f18c052f/self-automated_hikikomori/3D Printer/PrusaSlicer/Lid_of_servo_mini.3mf

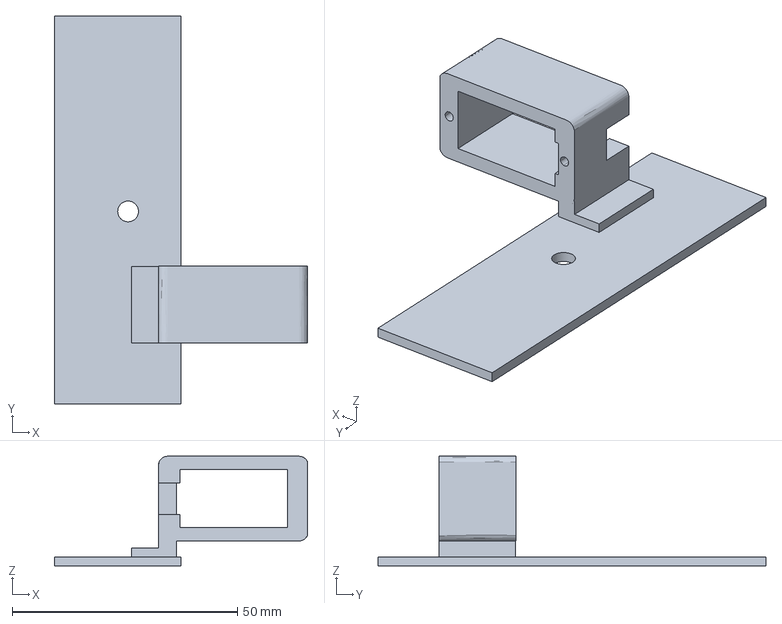
[picture p10: CAD file, 2025-05-03]
3D Printer/PrusaSlicer/Lid_of_servo_mini.3mf
56.1 x 86.0 x 24.3 mm
