f18c052f/self-automated_hikikomori/3D Printer/STL/Box.stl

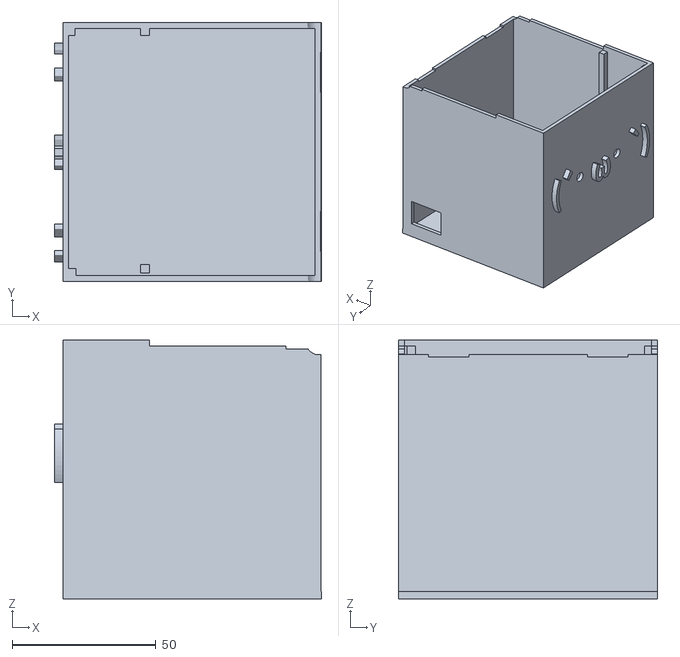
[picture p11: CAD file, 2025-05-03]
3D Printer/STL/Box.stl
92.9 x 90.0 x 90.0
