f18c052f/self-automated_hikikomori/3D Printer/PrusaSlicer/Lid_of_hinge_mini.3mf

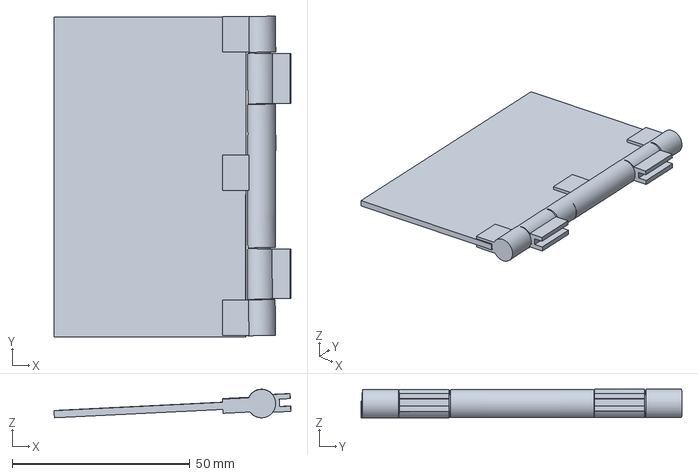
[picture p12: CAD file, 2025-05-03]
3D Printer/PrusaSlicer/Lid_of_hinge_mini.3mf
66.7 x 90.3 x 8.04 mm
