f18c052f/self-automated_hikikomori/3D Printer/STL/Arm.stl

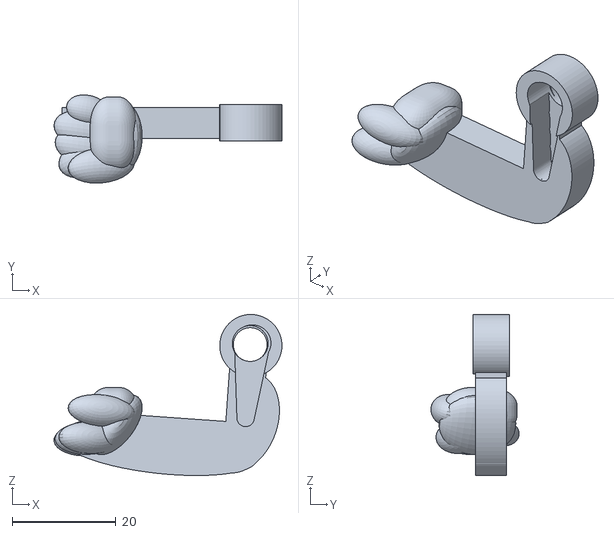
[picture p13: CAD file, 2025-05-03]
3D Printer/STL/Arm.stl
44.0 x 17.0 x 31.1
