f18c052f/self-automated_hikikomori/3D Printer/PrusaSlicer/Arm_mini.3mf

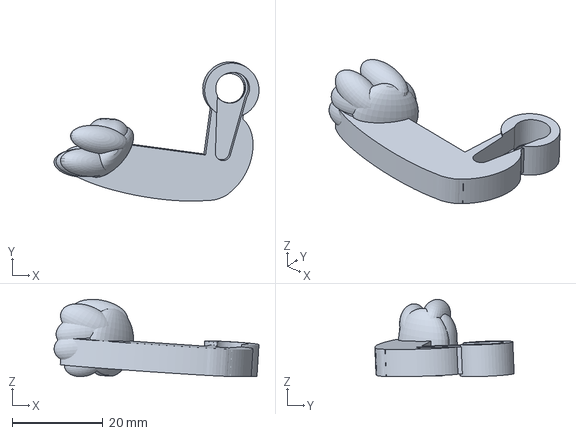
[picture p14: CAD file, 2025-05-03]
3D Printer/PrusaSlicer/Arm_mini.3mf
45.2 x 30.7 x 17.0 mm
