f18c052f/self-automated_hikikomori/(list of files, cad)

Other CAD files:
3D Printer/STL/Lid of hinge.stl
3D Printer/PrusaSlicer/Box_mini.3mf
3D Printer/STL/Lid with servo.stl
